LaskaKit/ESP32-C6-DEVKit/Version.md

### Version 2.0
- New power part, layout optimization | 
- New user button on pin io23
#### Version 1.1
- Mistake fixed, uSup power pin changed to 11 | 
#### Version 1.0
- Initial | Počáteční
