LaskaKit/ESP32-C6-DEVKit/img/LaskaKit-esp32-c6-devkit-wifi-6--bluetooth-5--zigbee-1.jpg

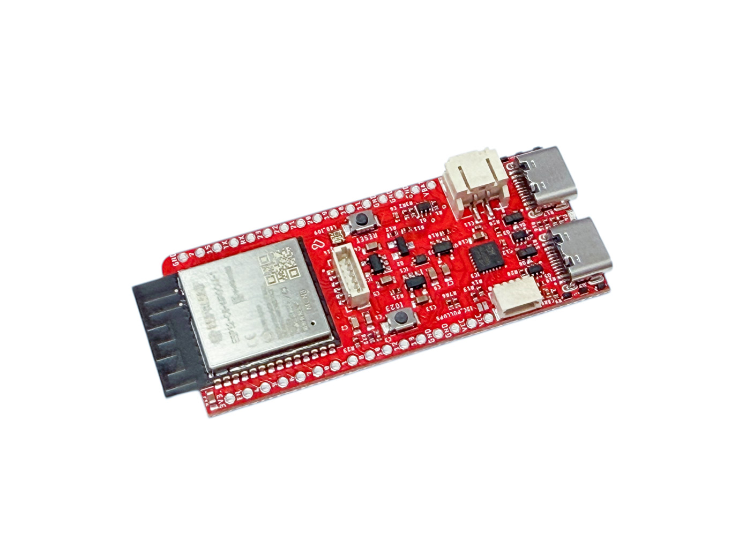
img/LaskaKit-esp32-c6-devkit-wifi-6--bluetooth-5--zigbee-1.jpg
