LaskaKit/ESP32-C6-DEVKit/HW/ESP32-C6-DEVKit_v2.pdf

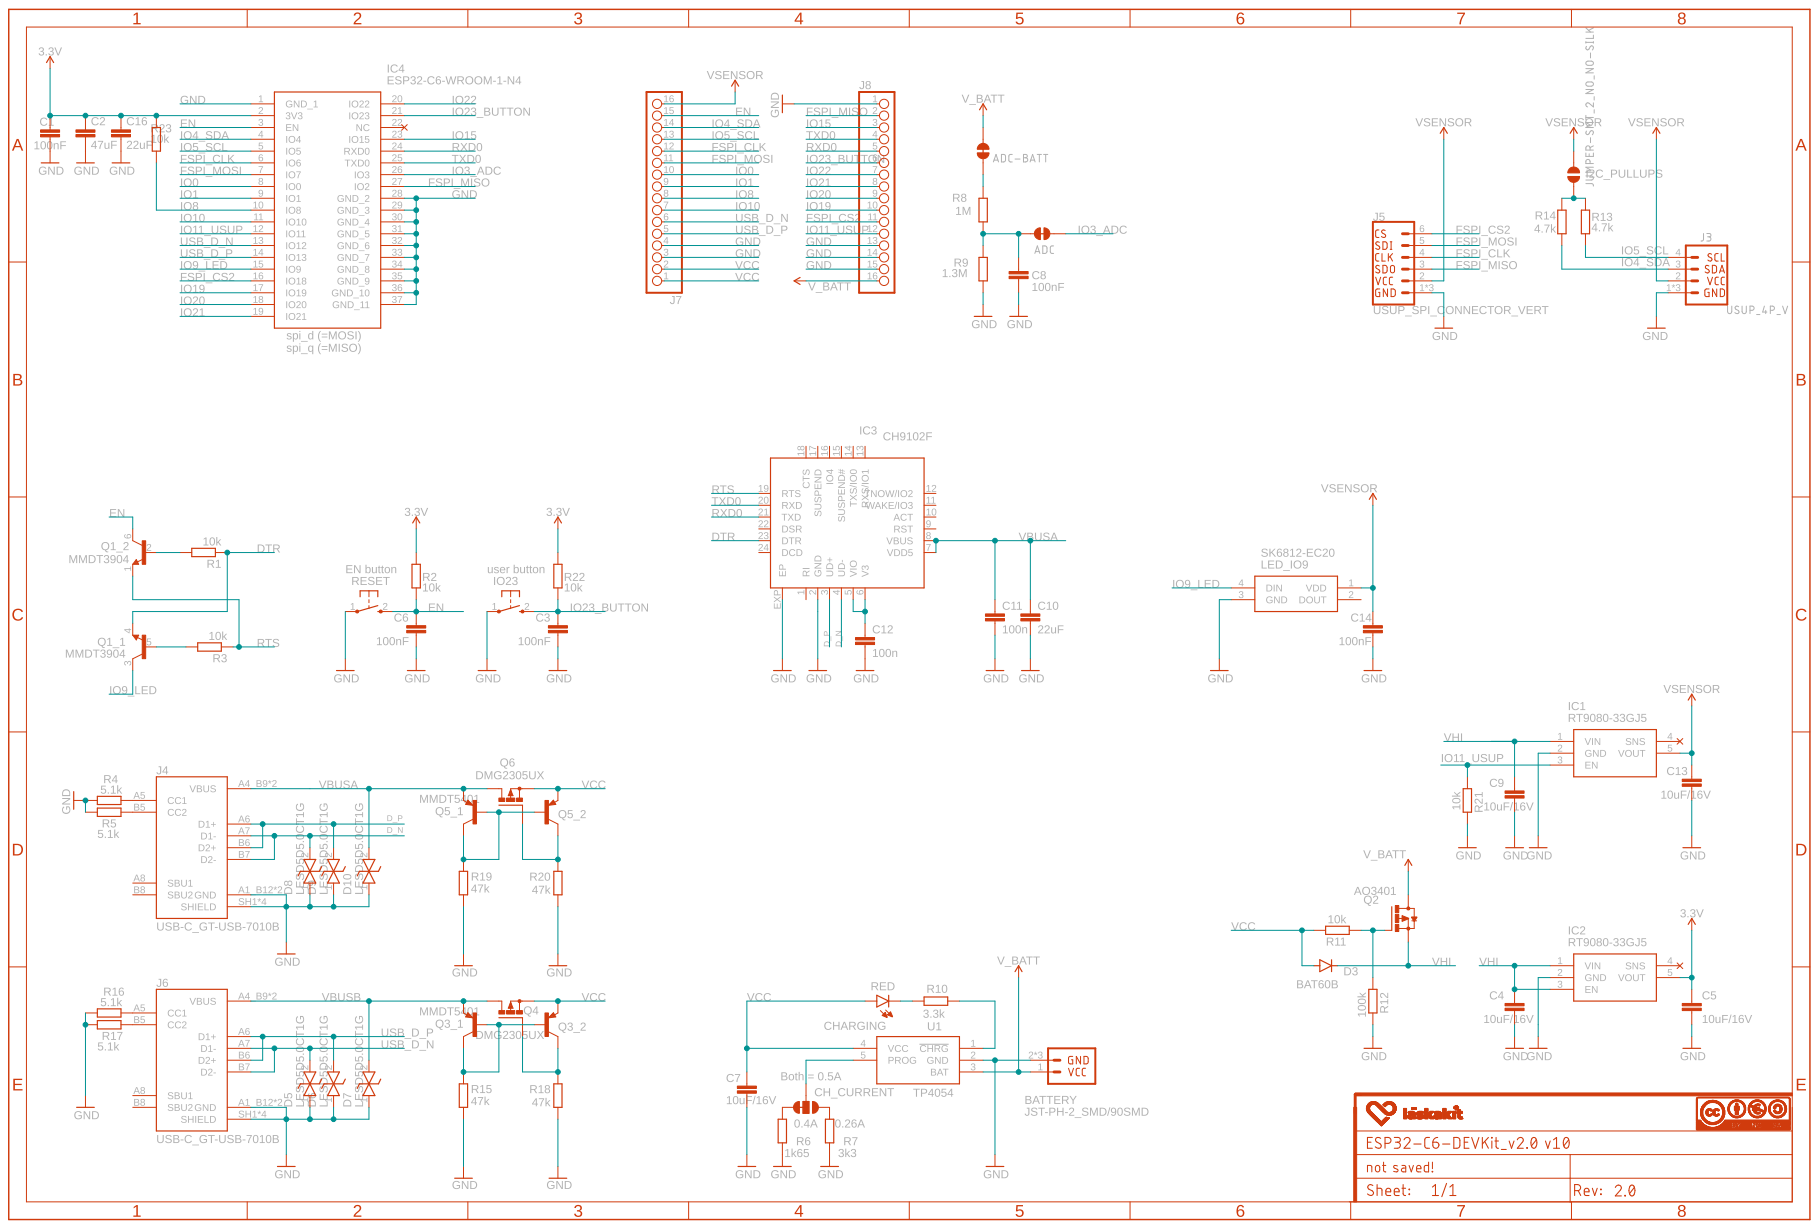
[picture p5: page 1]
