LaskaKit/ESP32-C6-DEVKit/HW/ESP32-C6-DEVKit_v1-0.pdf

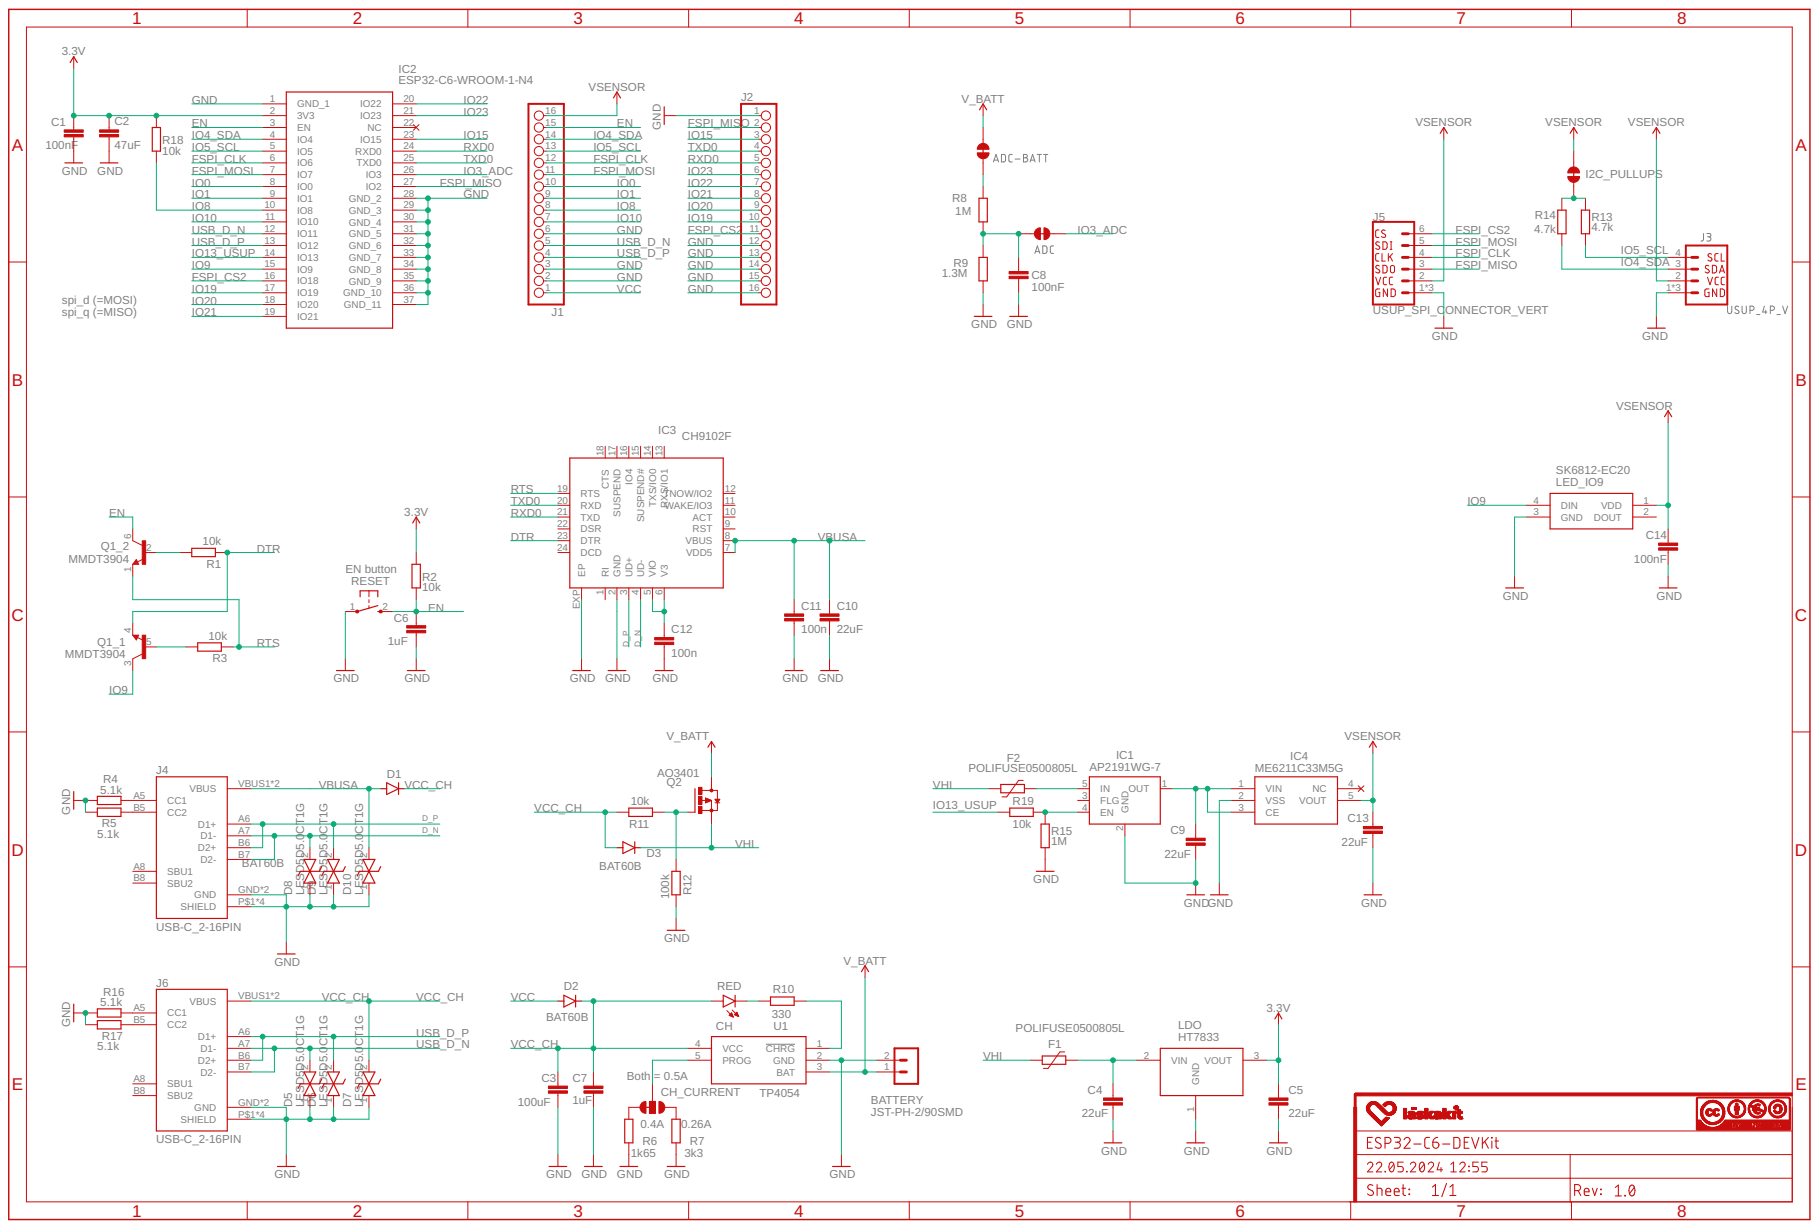
[picture p6: page 1]
