LaskaKit/ESP32-C6-DEVKit/HW/ESP32-C6-DEVKit_v1-1.pdf

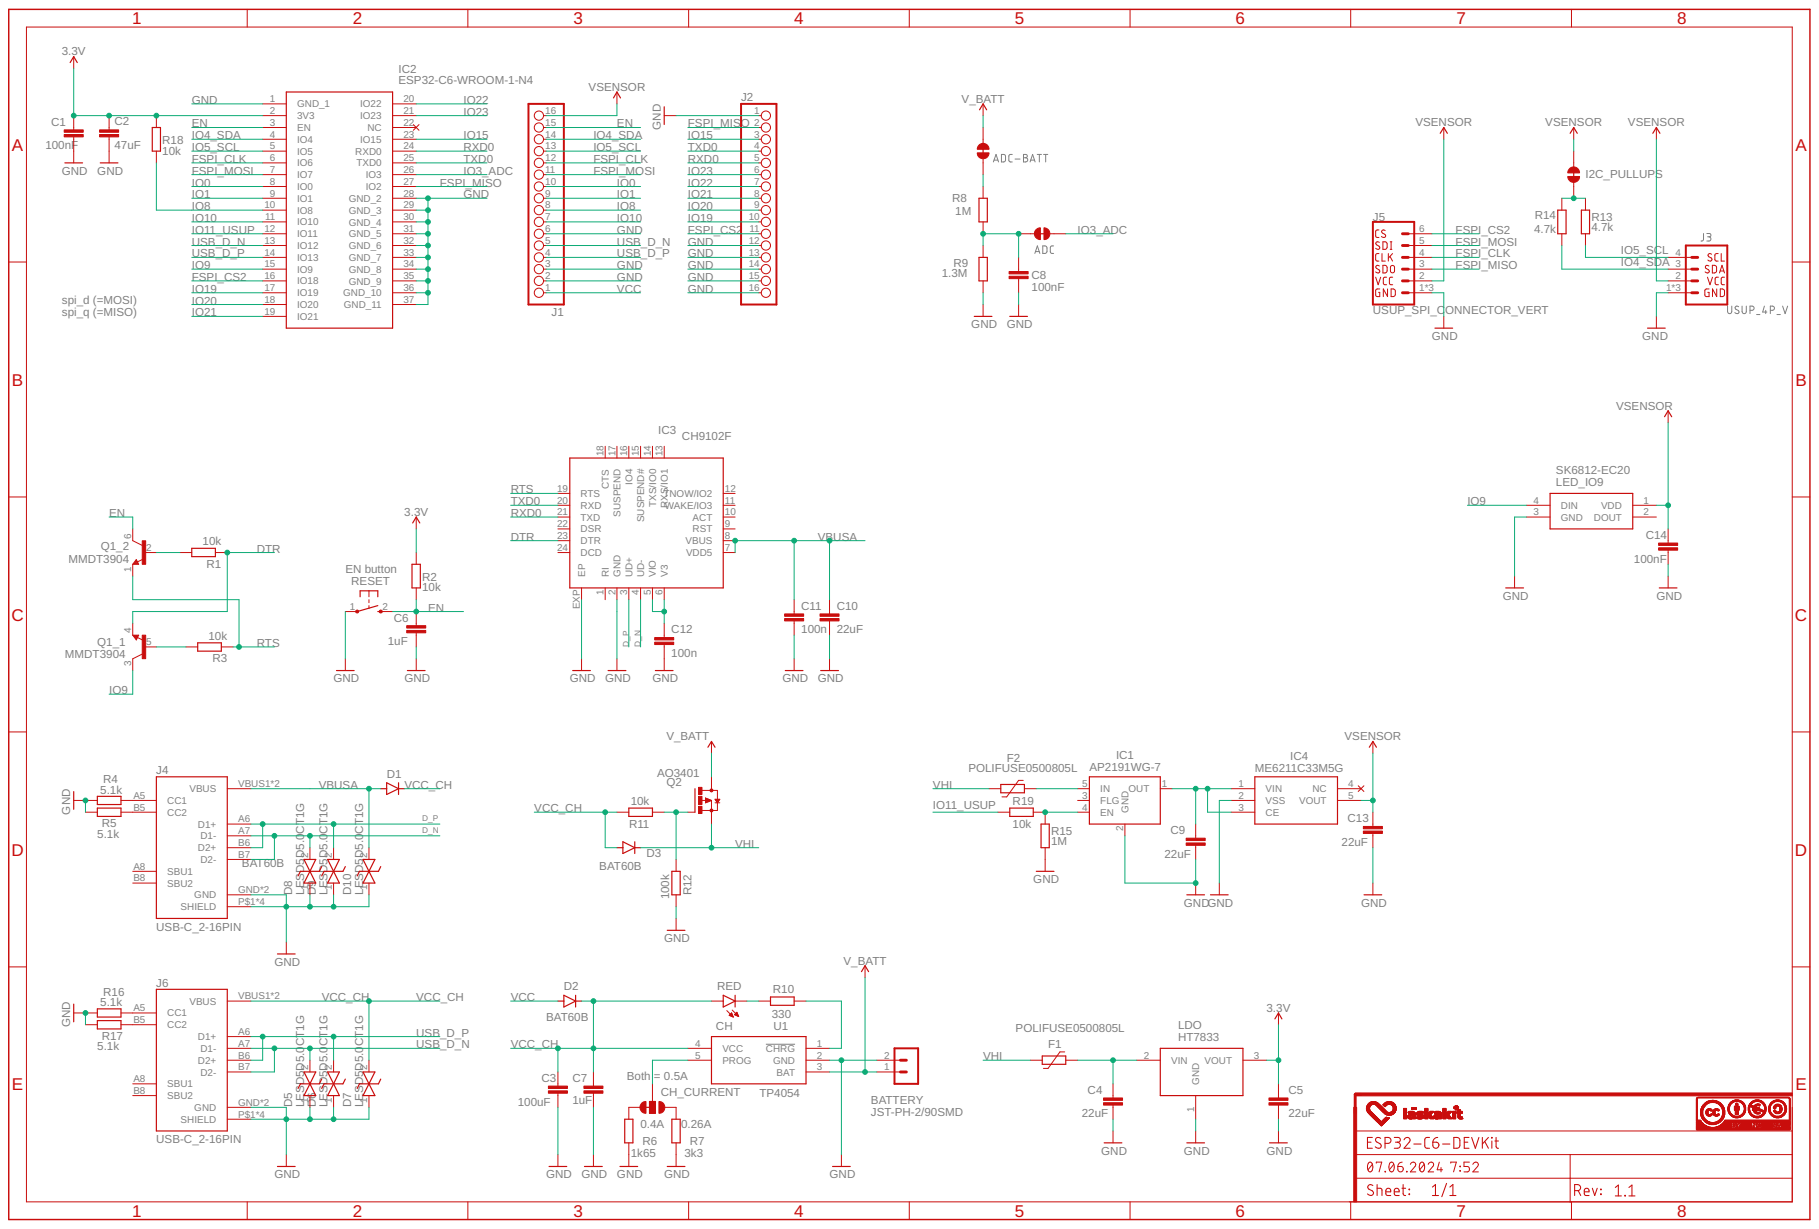
[picture p7: page 1]
