LaskaKit/ESP32-C6-DEVKit/(threads)

Thread 1 (2025-02-21):

This chip is ESP32-C6 not ESP32

Landkaml, 2025-02-21:
Hello,
how do I set up platformio.ini? I have another ESP32-devkit board and there I have this file set like this:
[env:esp32]
platform = espressif32
board = esp32dev
framework = arduino
monitor_speed = 115200

So how to set up WiFi 6, Bluetooth 5, Zigbee for LaskaKit ESP32-C6-DEVKit (Espressif ESP32-C6-DEVKITM-1).
I would like to use the same code for both boards.
Thank You

Konstantin-G, 2025-02-23:
Hi, half a second search on google> https://docs.platformio.org/en/latest/boards/espressif32/esp32-c6-devkitm-1.html

Landkaml, 2025-02-23:
Thank you,
This is what I found and did. Unfortunately it doesn't work with the Arduino platform.

Konstantin-G, 2025-02-24:
looks like it cannot be done with Arduino framework. Sorry
Only espidf now for C6 and Platformio

Closed 2025-02-23.
