LaskaKit/ESP32-C6-DEVKit/SW/ESP32-C6_DEVKit_LED/ESP32-C6_DEVKit_LED.ino

/* Board test for LaskaKit ESP32-C6-DEVkit
 * ESP32-C6-DEVKit just changing LED color
 * 
 * Board:   LaskaKit ESP32-C6-DEVkit  https://www.laskakit.cz/laskakit-esp32-c6-devkit-wifi-6--bluetooth-5--zigbee/
 * 
 * Email:podpora@laskakit.cz
 * Web:laskakit.cz
 */

// Requires Adafruit NeoPixel library

#include <Adafruit_NeoPixel.h>
#define PIN_ON 11
#define PIN_LED 9

Adafruit_NeoPixel pixels = Adafruit_NeoPixel(1, PIN_LED, NEO_GRB + NEO_KHZ800);

void setup() {
  Serial.begin(115200);
  pinMode(PIN_ON, OUTPUT);      // Set EN pin for second stabilisator as output
  digitalWrite(PIN_ON, HIGH);   // Turn on the second stabilisator
  delay(100);

  pixels.begin();
  pixels.setBrightness(10);
}

void loop() {
     
  pixels.setPixelColor(0, pixels.Color(255, 0, 0)); // R, G, B
  pixels.show();

  delay(1000);

  pixels.setPixelColor(0, pixels.Color(0, 255, 0)); // R, G, B
  pixels.show();

  delay(1000);

  pixels.setPixelColor(0, pixels.Color(0, 0, 255)); // R, G, B
  pixels.show();

  delay(1000);

  pixels.setPixelColor(0, pixels.Color(255, 255, 255)); // R, G, B
  pixels.show();

  delay(1000);

}
