LaskaKit/ESP32-C6-DEVKit/SW/ESP32-C6_DEVkit_UART/ESP32-C6_DEVkit_UART.ino

/*
* Example code for ESP32-H2-DEVkit evaluation board made by laskakit.cz
* Firmware sends message through serial com port (UART)
* "laskakit.cz" 
* "ESP32-C6-DEVkit"
* The message is sent every second
*
* Created by (c) laskakit.cz 2024
*
* Libraries:
* -
*/
 
void setup() {
  Serial.begin(115200);
  while (!Serial) 
  {
    ; // waiting for serial com port
  }
}
 
void loop() {
  Serial.println("laskakit.cz");
  Serial.println("ESP32-C6-DEVkit");
  delay(1000);
}
