LaskaKit/ESP32-C6-DEVKit/(commit log)

2024-06-07 changed power pin
    [ESP32-C6-DEVKit_top_bom.csv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]
2024-07-31 added delay after pin on
2024-08-14 Create ESP32-C6-DEVKit v1-1.step
2024-08-14 Create ESP32-C6-DEVKit v1-1.f3d
2025-11-24 new ver
    [ESP32-C6-DEVKit_v2.0 v20_bom.csv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]
